jh1995/til311-x4-clock/hardware/KiCad/README

KiCad design files for the PCB and the companion Arduino firmware.
