jh1995/til311-x4-clock/software/Arduino/README

Arduino sketch that works with the companion hardware board.
