jh1995/til311-x4-clock/hardware/KiCad/ArduinoNano-TIL311-4x.pdf

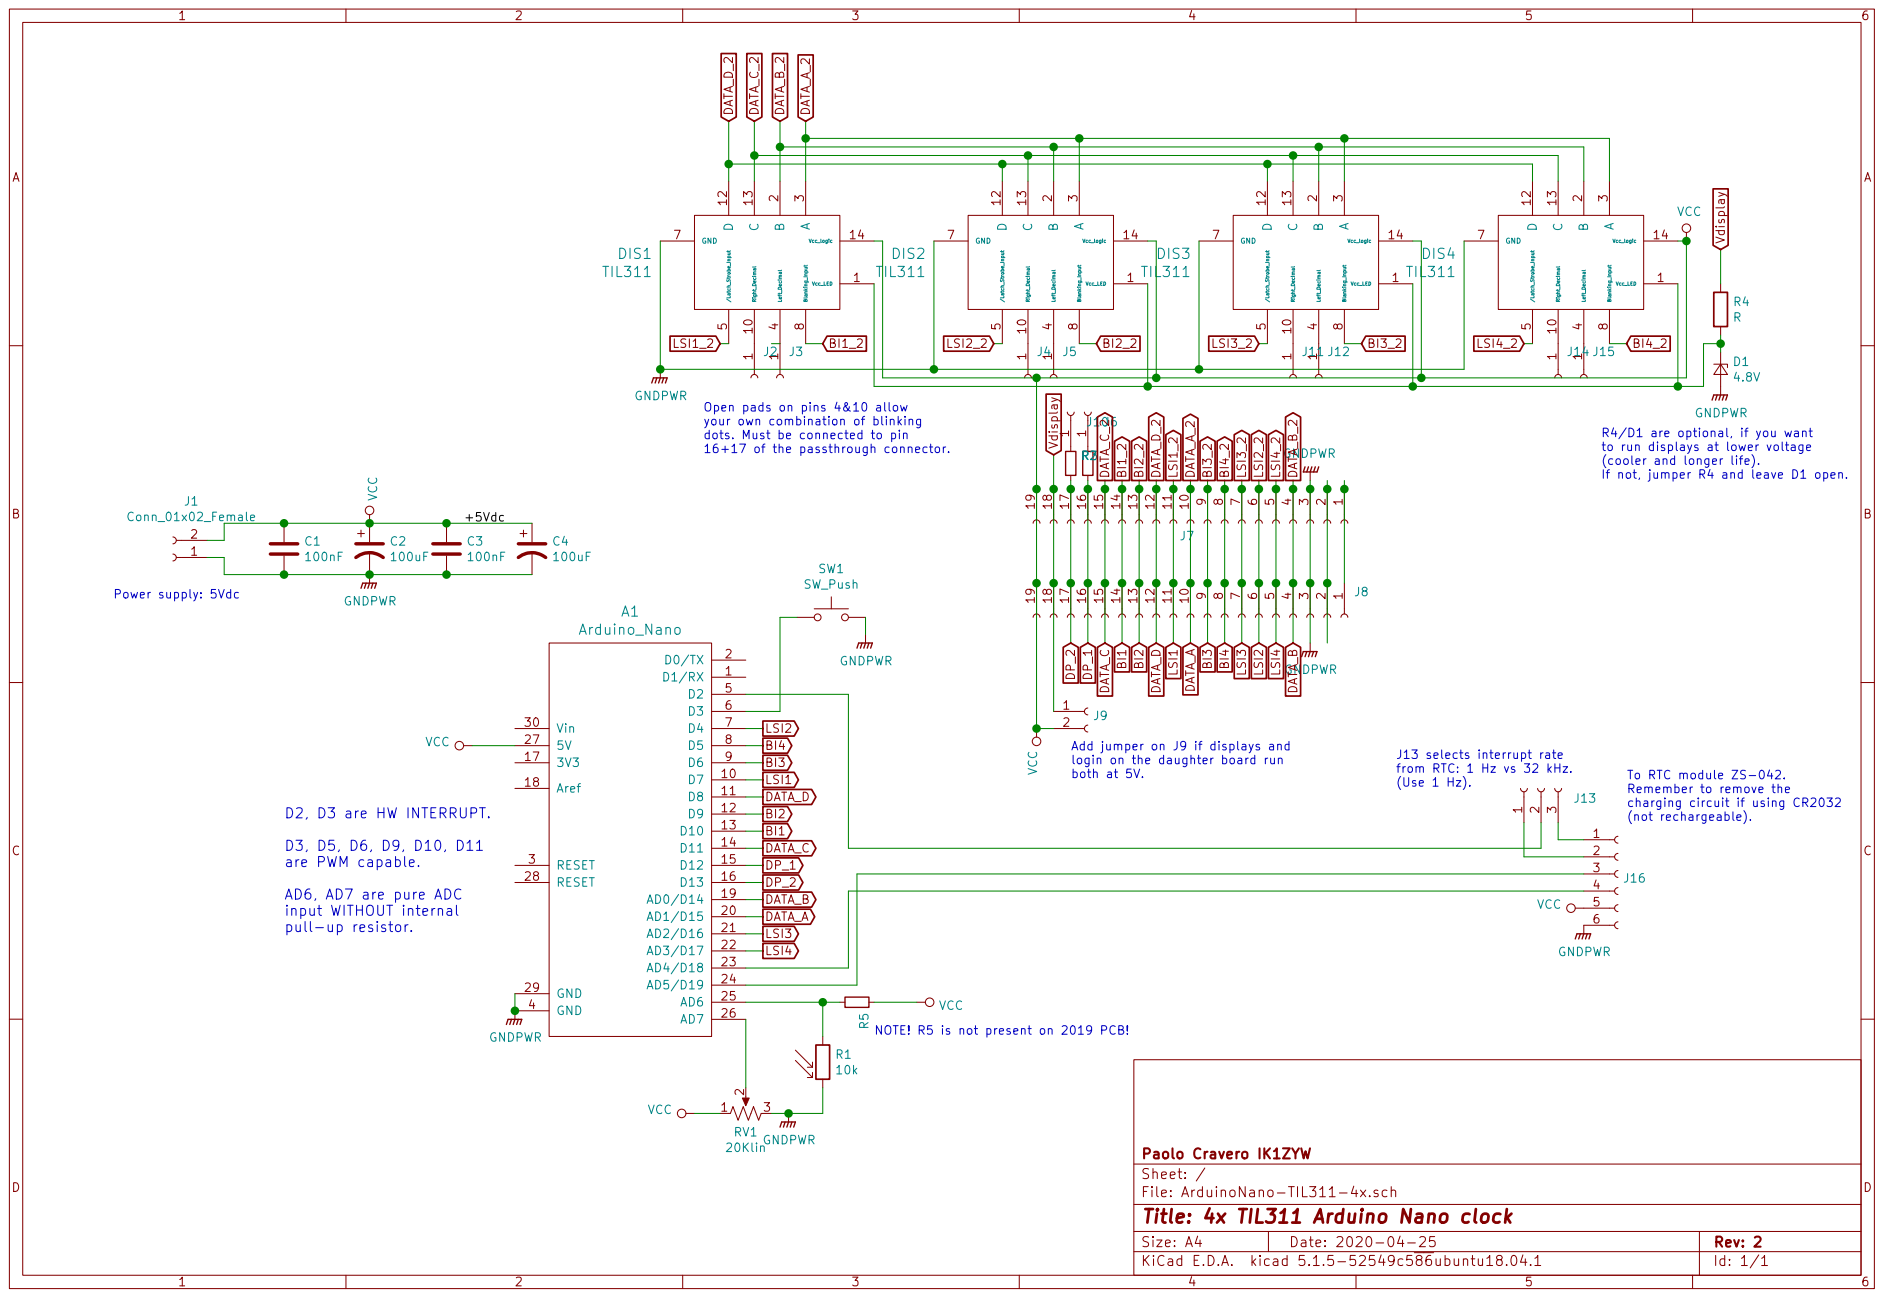
[picture p1: page 1]

Open pads on pins 4&10 allow
your own combination of blinking
dots. Must be connected to pin
16+17 of the passthrough connector.

R4/D1 are optional, if you want
to run displays at lower voltage
(cooler and longer life).
If not, jumper R4 and leave D1 open. To RTC module ZS-042. Remember to remove the

Add jumper on J9 if displays and
login on the daughter board run

from RTC: 1 Hz vs 32 kHz. (Use 1 Hz).
J13 VCCGNDPWR

NOTE! R5 is not present on 2019 PCB!

File: ArduinoNano-TIL311-4x.sch Sheet: / Paolo Cravero IK1ZYW

Id: 1/1 Title: 4x TIL311 Arduino Nano clock
