jh1995/til311-x4-clock/hardware/KiCad/ArduinoNano-TIL311-4x.sch

## KiCad design hardware/KiCad/ArduinoNano-TIL311-4x.sch (2020-10-12)

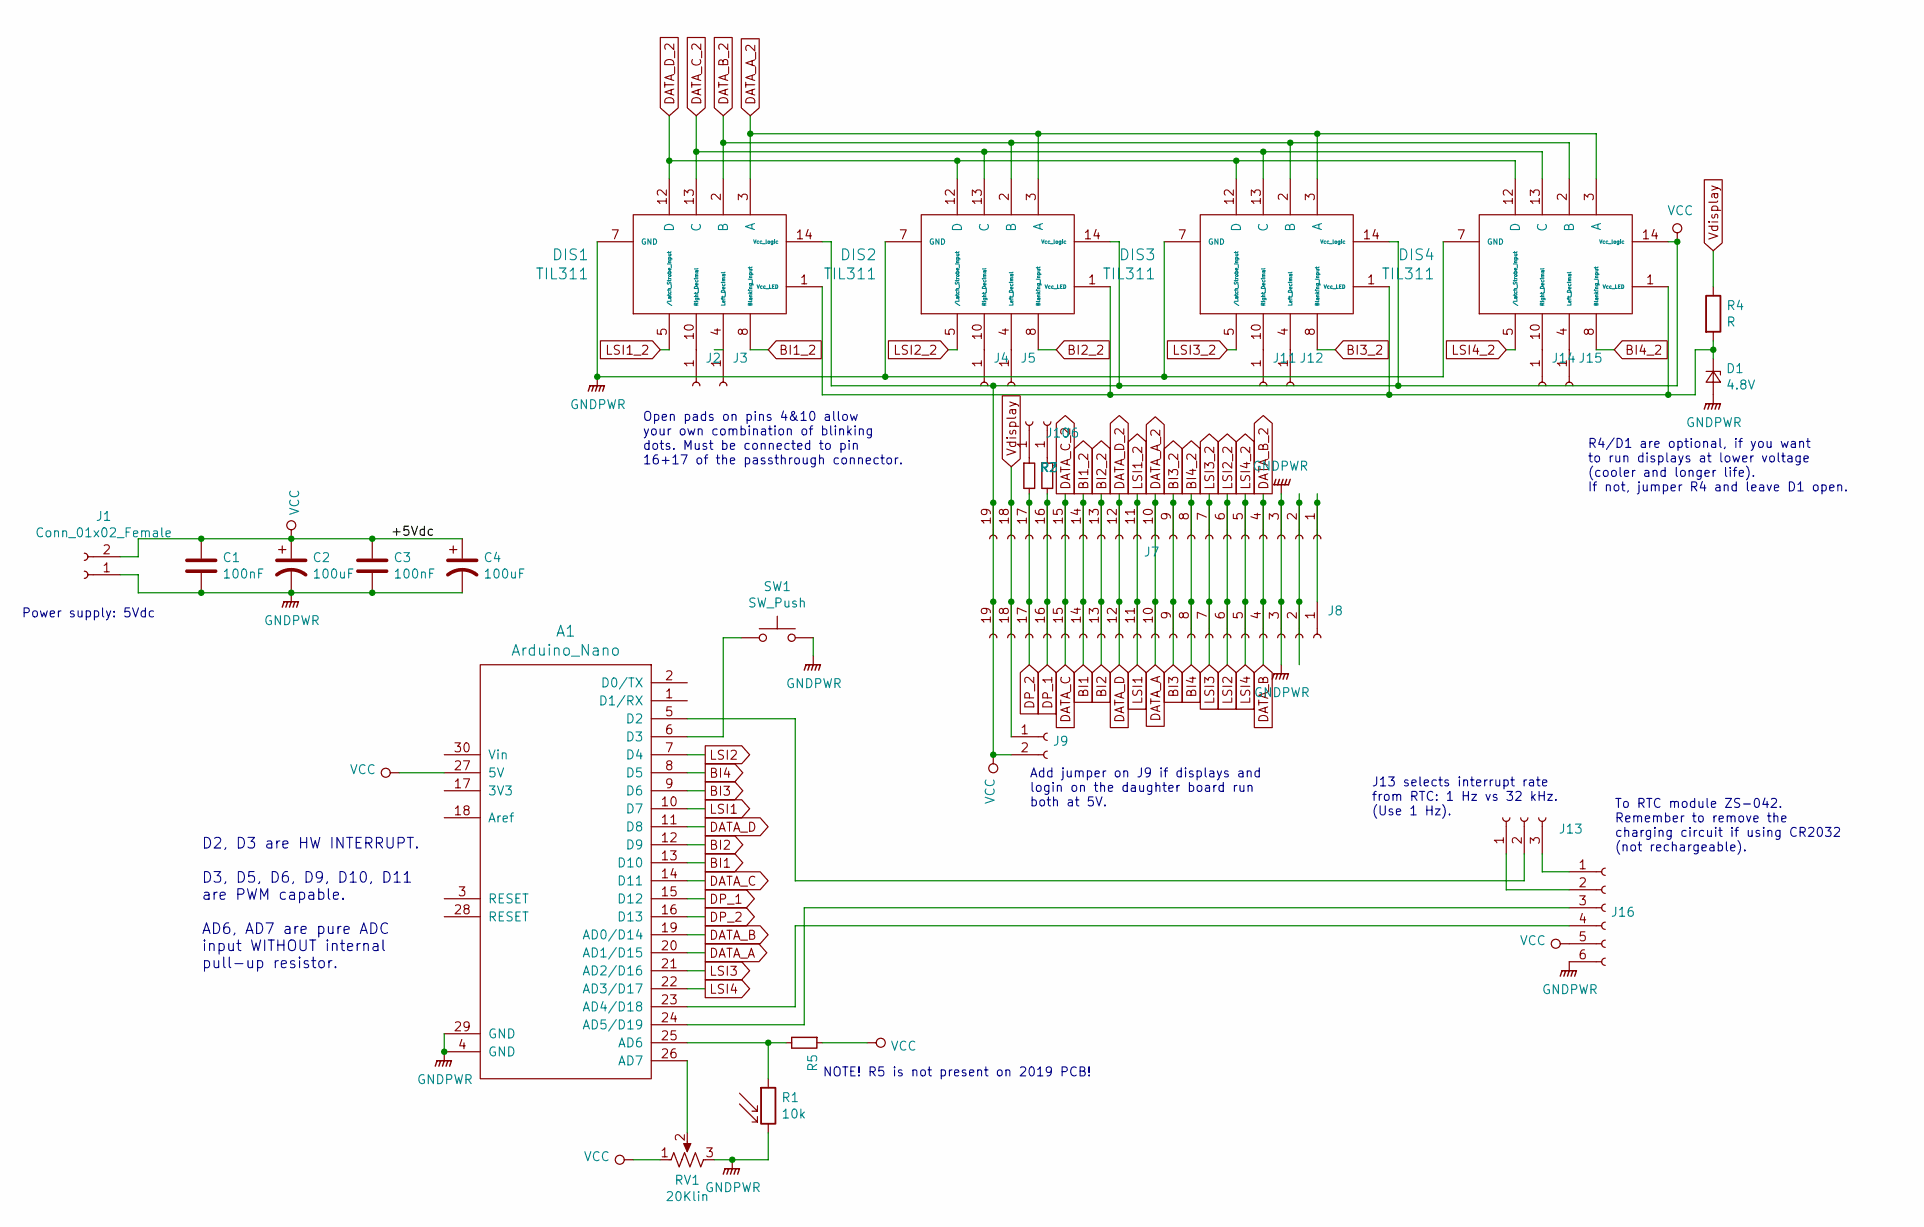
[picture p2: schematic ArduinoNano-TIL311-4x.sch]

Parts:
A1: Arduino_Nano; arduino_nano
C1, C3: 100nF; C_Rect_L4.6mm_W2.0mm_P2.50mm_MKS02_FKP02
C2, C4: 100uF; CP_Radial_D8.0mm_P3.50mm
D1: 4.8V; D_A-405_P10.16mm_Horizontal
DIS1, DIS2, DIS3, DIS4: TIL311
J1: Conn_01x02_Female; Molex_KK-254_AE-6410-02A_1x02_P2.54mm_Vertical
J2, J3, J4, J5, J6, J10, J11, J12, J14, J15: Conn_01x01_Female; PinHeader_1x01_P1.27mm_Vertical
J7, J8: Conn_01x19_Female; PinHeader_1x19_P2.54mm_Vertical
J9: Conn_01x02_Female; PinHeader_1x02_P2.54mm_Vertical
J13: Conn_01x03_Female; SolderJumper-3_P1.3mm_Open_Pad1.0x1.5mm
J16: Conn_01x06_Female; PinHeader_1x06_P2.54mm_Vertical
R1: 10k; Molex_KK-254_AE-6410-02A_1x02_P2.54mm_Vertical
R2, R3, R5: R_Small; R_Axial_DIN0309_L9.0mm_D3.2mm_P2.54mm_Vertical
R4: R; R_Axial_DIN0414_L11.9mm_D4.5mm_P15.24mm_Horizontal
RV1: 20Klin; Molex_KK-254_AE-6410-03A_1x03_P2.54mm_Vertical
SW1: SW_Push; Molex_KK-254_AE-6410-02A_1x02_P2.54mm_Vertical

Connections:
BI1: A1.13 (D10), DIS1.8 (Blanking_Input), J7.14, J8.14
BI2: A1.12 (D9), DIS2.8 (Blanking_Input), J7.13, J8.13
BI3: A1.9 (D6), DIS3.8 (Blanking_Input), J7.9, J8.9
BI4: A1.8 (D5), DIS4.8 (Blanking_Input), J7.8, J8.8
DATA_A: A1.20 (AD1/D15), DIS1.3 (A), DIS2.3 (A), DIS3.3 (A), DIS4.3 (A), J7.10, J8.10
DATA_B: A1.19 (AD0/D14), DIS1.2 (B), DIS2.2 (B), DIS3.2 (B), DIS4.2 (B), J7.4, J8.4
DATA_C: A1.14 (D11), DIS1.13 (C), DIS2.13 (C), DIS3.13 (C), DIS4.13 (C), J7.15, J8.15
DATA_D: A1.11 (D8), DIS1.12 (D), DIS2.12 (D), DIS3.12 (D), DIS4.12 (D), J7.12, J8.12
DP_1: A1.15 (D12), J7.16, J8.16, R2.2
DP_2: A1.16 (D13), J7.17, J8.17, R3.2
GNDPWR: A1.4 (GND), A1.29 (GND), C1.2, C2.2, C3.2, C4.2, D1.2 (A), DIS1.7 (GND), DIS2.7 (GND), DIS3.7 (GND), DIS4.7 (GND), J1.1, J7.3, J8.3, J16.6, R1.2, RV1.3, SW1.2
LSI1: A1.10 (D7), DIS1.5 (/Latch_Strobe_Input), J7.11, J8.11
LSI2: A1.7 (D4), DIS2.5 (/Latch_Strobe_Input), J7.6, J8.6
LSI3: A1.21 (AD2/D16), DIS3.5 (/Latch_Strobe_Input), J7.7, J8.7
LSI4: A1.22 (AD3/D17), DIS4.5 (/Latch_Strobe_Input), J7.5, J8.5
unnamed: A1.5 (D2), J13.2
unnamed: A1.6 (D3), SW1.1
unnamed: A1.23 (AD4/D18), J16.4
unnamed: A1.24 (AD5/D19), J16.3
unnamed: A1.25 (AD6), R1.1, R5.2
unnamed: A1.26 (AD7), RV1.2
unnamed: D1.1 (K), DIS1.1 (Vcc_LED), DIS2.1 (Vcc_LED), DIS3.1 (Vcc_LED), DIS4.1 (Vcc_LED), R4.2
unnamed: DIS1.4 (Left_Decimal), J3.1
unnamed: DIS1.10 (Right_Decimal), J2.1
unnamed: DIS2.4 (Left_Decimal), J5.1
unnamed: DIS2.10 (Right_Decimal), J4.1
unnamed: DIS3.4 (Left_Decimal), J12.1
unnamed: DIS3.10 (Right_Decimal), J11.1
unnamed: DIS4.4 (Left_Decimal), J15.1
unnamed: DIS4.10 (Right_Decimal), J14.1
unnamed: J6.1, R2.1
unnamed: J7.1, J8.1
unnamed: J7.2, J8.2
unnamed: J10.1, R3.1
unnamed: J13.1, J16.2
unnamed: J13.3, J16.1
VCC: A1.27 (5V), C1.1, C2.1, C3.1, C4.1, DIS1.14 (Vcc_logic), DIS2.14 (Vcc_logic), DIS3.14 (Vcc_logic), DIS4.14 (Vcc_logic), J1.2, J7.19, J8.19, J9.2, J16.5, R5.1, RV1.1
Vdisplay: J7.18, J8.18, J9.1, R4.1

Notes on the sheet:
D2, D3 are HW INTERRUPT. D3, D5, D6, D9, D10, D11 are PWM capable. AD6, AD7 are pure ADC input WITHOUT internal pull-up resistor.
NOTE! R5 is not present on 2019 PCB!
Power supply: 5Vdc
To RTC module ZS-042. Remember to remove the charging circuit if using CR2032 (not rechargeable).
R4/D1 are optional, if you want to run displays at lower voltage (cooler and longer life). If not, jumper R4 and leave D1 open.
Open pads on pins 4&10 allow your own combination of blinking dots. Must be connected to pin 16+17 of the passthrough connector.
J13 selects interrupt rate from RTC: 1 Hz vs 32 kHz. (Use 1 Hz).
Add jumper on J9 if displays and login on the daughter board run both at 5V.
