jh1995/til311-x4-clock/(threads)

Thread 2 (2020-01-27):

Potentiometer not stable

jh1995, 2020-01-27:
The pot value read by the ADC can be noisy and result in difficult setting for parameters with lots of values (like minutes that span from 0 to 59). Implement a software filter or a hardware solution.

jh1995, 2020-03-07:
Split the handling of 2-digit numbers on a number-by-number fashion.

jh1995, 2020-03-10:
No need to split 2-digit numbers, rather use a WORKING potentiometer!! Solved with a new, clean, working potentiometer.

Closed 2020-03-10.
