jh1995/til311-x4-clock/(commit log)

2020-01-27 Added time counter, button handling, RTC update via UI
    Added button handling: short press activates the time counter, long press enters the set mode.
    The time counter displays " CO " and waits for a start command with a short button press. While counting you can pause it with a short press to get an intermediate time. Then, a short press will restore the running display. While paused, a long press will return to normal clock operation.
    Long press from clock mode enters RTC update. Navigation is done through short presses, while value setting is implemented via the potentiometer. Sequence is: HH, MM, DD, MM, YY. A long press while setting disables writing to the RTC (but you still need to p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
    [TIL311-x4-clock.ino]
2020-01-28 Bugfix on hexword randomization
    [TIL311-x4-clock.ino]
2020-01-30 More words and fixed randomizer
    Also, no more serial output each minute.
    [TIL311-x4-clock.ino]
2020-01-31 Bug #2 fixed. Added fadeIn/Out
    [TIL311-x4-clock.ino]
2020-02-01 Added MSD blank on '0'. Added more words.
    Fixed #4.
    [TIL311-x4-clock.ino]
2020-03-04 Added night mode + minor bug fix
    Now there is a night mode that is activated at power up if the potentiometer is fully closed. It works like this: between 00:00 and 08:00 the time is displayed as usual. Between 8 AM and midnight the display is normally off (except blinking dots, unless it is totally dark) until there is a change in light intensity hitting the LDR (must be installed, obviously). If the light intensity changes more than the threshold when the timeout is about to expire, then the timeout counter is reset to the top value.
    [TIL311-x4-clock.ino]
2020-03-08 bug fix on blank handling during night mode
    [TIL311-x4-clock.ino]
2020-03-10 Various improvements, see detail
    When setting the time/date, if the pot is not rotated the current value is not changed. This way you can cycle to the - say - day-of-month leaving the time intact. Just remember that the time will be written back to :00 seconds.
    When setting the month, now the upper limit is enforced, so you cannot try to set 31st February.
2020-03-11 Bug fix
    Sunday is shown as day 7. Luminosity is autoadjusted during upcounter mode.
    [TIL311-x4-clock.ino]
2020-10-12 Add files via upload
    Version 4 (stable) of KiCad design files. Bug fix over version 3 (never published).
    [ArduinoNano-TIL311-4x.sch]
